floscha17/Bench/docs/vorentwurf-studio.pdf

STUDIOENTWURF / FITNESSMÖBEL

# Wohnbank mit Trainingsfunktion

Eiche · cognacfarbenes Leder · verschwindende Rollfront · verdeckte Mobilität

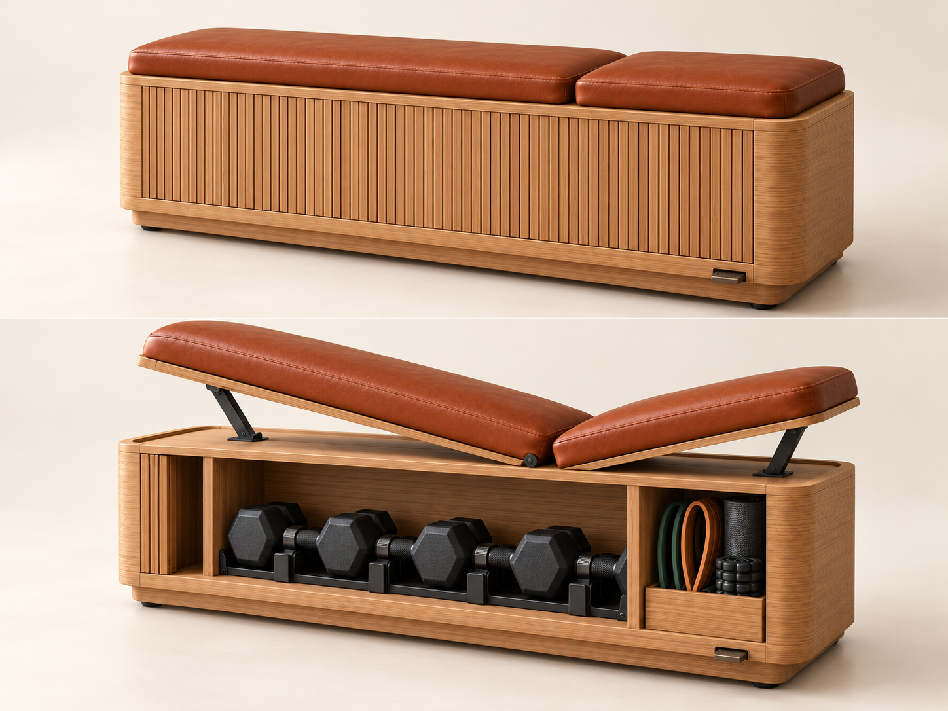
[picture p14: figure]

V01 · 24.10.2026 · Besprechungsgrundlage, keine Fertigungsfreigabe | 01 / 07

GESTALTUNGSZIEL

Ein hochwertiges Wohnmöbel, das sich mit wenigen Handgriffen in eine Schrägbank verwandelt.

### 01 ZWEI POLSTER

Lange Rückenlehne und kurzer Sitz separat anstellbar; geschlossen beide flach.

### 02 FREIE FRONT

Lamellen laufen nach links um die Ecke und im Korpus weiter nach hinten.

### 03 SICHER VERSTAUT

Hanteln einzeln in gepolsterten, verriegelbaren Aufnahmen.

### 04 BEWEGLICH

Vier Rollen gemeinsam ausfahren. Zum Training auf feste Füße absetzen.

Visualisierung der Gestaltung. Hantelzahl, Beschläge und Proportionen im Rendering sind nicht maßverbindlich. Verbindliche Abstimmung anhand der folgenden Maß- und Funktionsblätter.

# Abmessungen und Proportionen

Alle Maße in mm · Vorschlag zur Abstimmung · Zeichnungen 1:8 bei Ausdruck auf A4 mit 100 %

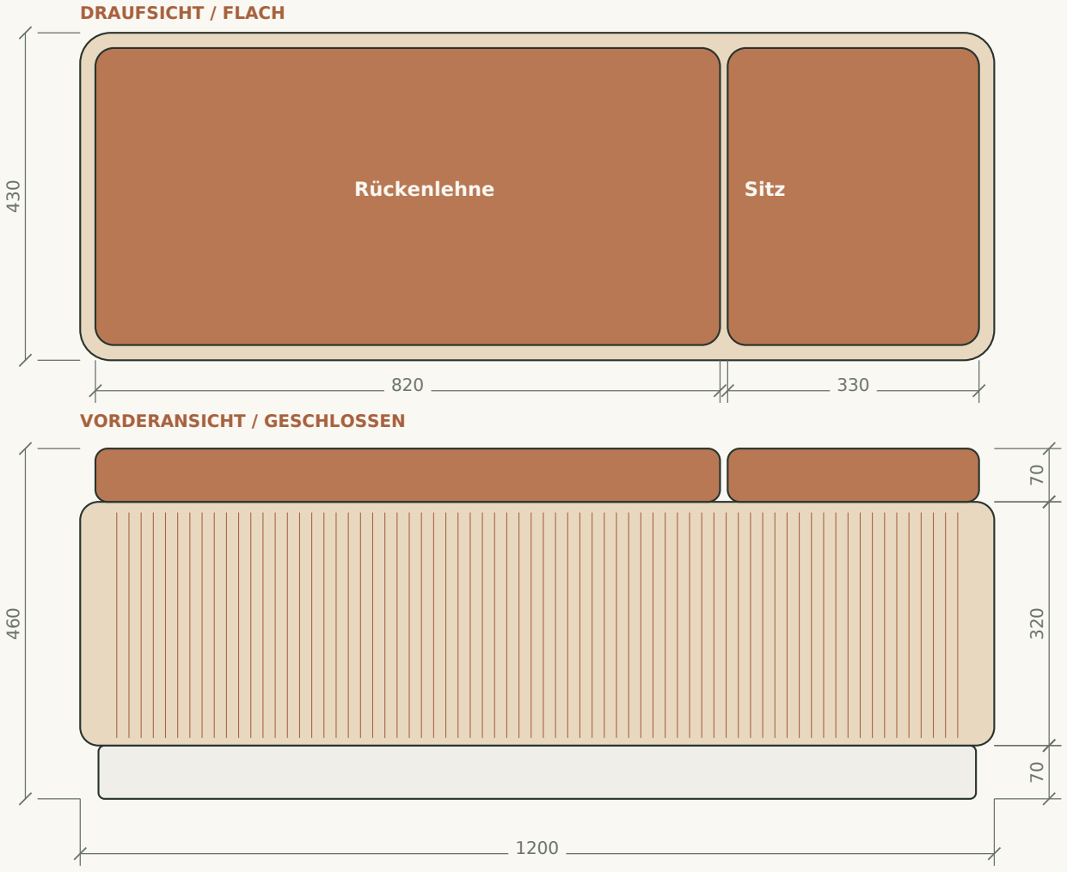
[picture p15: figure]
VORDERANSICHT / GESCHLOSSEN; DRAUFSICHT / FLACH; Rückenlehne; Sitz
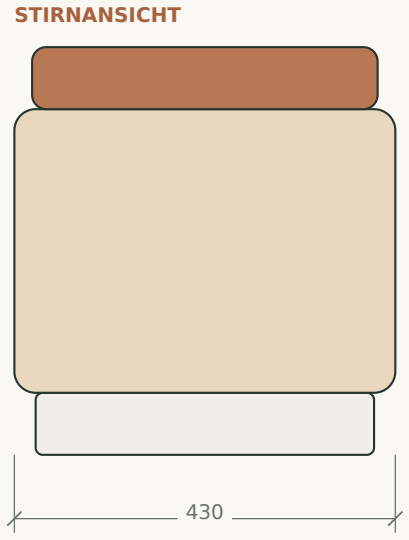
[picture p16: figure]
STIRNANSICHT

V01 · 24.10.2026 · Besprechungsgrundlage, keine Fertigungsfreigabe | 02 / 07

PLANUNGSWERTE

Außen: 1200 × 430 × 460
Polster: 820 + 10 Fuge + 330 Rand links/rechts: je 20
Polsterbreite: 390
Aufbau Polster + Träger: 70 Sockel inkl. Füße: 70

Maßkette Länge: 20 + 820 + 10 + 330 + 20 = 1200. Höhe: 70 Sockel + 320 Korpus + 70 Polsterpaket = 460. Sockelhöhe und Polsterbreite nach Beschlagwahl bzw. Liegeprobe ggf. anpassen.

# Zwei unabhängig verstellbare Polster

Funktionsskizze · Außenkontur 1:8 · Beschläge und Lastpfade sind schematisch

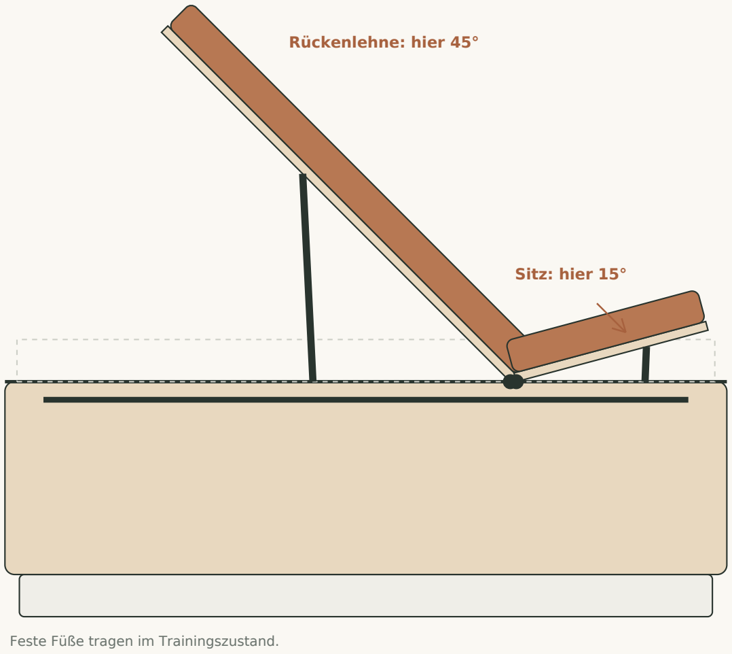
[picture p17: figure]
Rückenlehne: hier 45°; Sitz: hier 15°; Feste Füße tragen im Trainingszustand.

V01 · 24.10.2026 · Besprechungsgrundlage, keine Fertigungsfreigabe | 03 / 07

VERSTELLBEREICHE / ZIEL

Rückenlehne: 0 / 15 / 30 / 45 / 60°
Sitz: 0 / 10 / 15°

Rastpunkte sind Vorschläge. Ergonomie und verfügbare Beschläge entscheiden über die endgültigen Stellungen.

KONSTRUKTIVE VORGABE

Beide Träger an einem gemeinsamen inneren Metallrahmen lagern. Quer abgestützte, formschlüssig verriegelnde Beschläge verwenden; keine einfache Möbelklappenstütze als Lastaufnahme.

VOR FREIGABE PRÜFEN

Schulterfreiheit bei 390 mm Polsterbreite; Spalt am Gelenk; Fingerfreiheit; Verriegelung in jeder Stellung; dynamische Trainingslasten und Kippsicherheit.

Die Zeichnung legt keine Stahlquerschnitte, Bolzendurchmesser oder Traglast fest. Metallbauer / Beschlaglieferant müssen die Auslegung übernehmen.

# Rollfront: nach links um die Ecke

Draufsicht ohne Polster / Deckplatte · schematischer Laufweg · Außenkontur 1:5

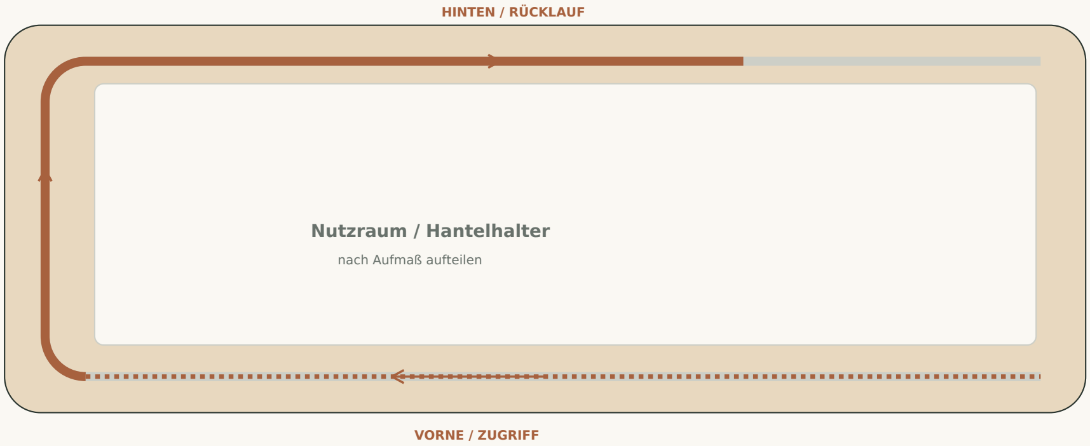
[picture p18: figure]
Nutzraum / Hantelhalter; nach Aufmaß aufteilen; VORNE / ZUGRIFF; HINTEN / RÜCKLAUF

V01 · 24.10.2026 · Besprechungsgrundlage, keine Fertigungsfreigabe | 04 / 07

LAMELLEN & FÜHRUNG

Schmale Eichenlamellen auf flexiblem Träger; oben und unten geführt. Laufweg gestrichelt = geschlossen, durchgezogen = zurückgeschoben.

BAURAUM RESERVIEREN

Linke Seite und Rückwand benötigen einen getrennten Rücklaufkanal. Innenraum deshalb nicht aus den Außenmaßen ableiten.

BESCHLAG BESTIMMT DETAILS

Kurvenradius, Lamellenbreite, Dicke, Fugen und Nuten nach einem geeigneten Rolladensystem festlegen. Schablone vor Fertigung testen.

# Hanteln einhängen und gegen Bewegung sichern

Prinzipdarstellung einer Einzelaufnahme · nicht maßstäblich · an die tatsächlichen Hanteln anpassen

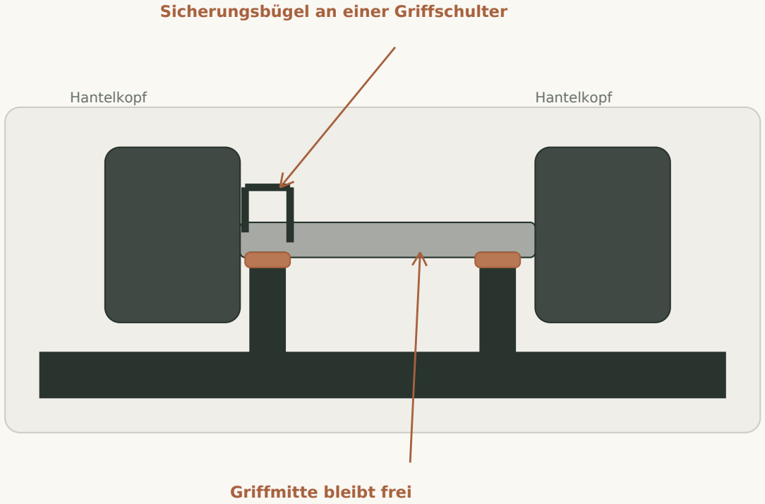
[picture p19: figure]
Sicherungsbügel an einer Griffschulter; Griffmitte bleibt frei; Hantelkopf

V01 · 24.10.2026 · Besprechungsgrundlage, keine Fertigungsfreigabe | 05 / 07

AUFNAHMEPRINZIP

Zwei gepolsterte Auflagen tragen die Hantel nahe den Köpfen. Seitliche Anschläge begrenzen das Verschieben; ein lösbarer Bügel verhindert Herausspringen.

BEDIENUNG

Bügel lösen, Hantel leicht anheben und entnehmen. Beim Einsetzen muss die Verriegelung eindeutig erkennbar schließen.

BEFESTIGUNG

Aufnahmen verschraubt an Metalltraversen; keine tragenden Haken nur in einer dünnen Holzrückwand. Polster austauschbar vorsehen.

Kapazität erst nach Aufmaß festlegen: Das frühere Rendering mit zwei vollen Hantelreihen ist keine bestätigte Innenaufteilung.

Benötigt: Anzahl, Gewicht, Gesamtlänge, Kopfdurchmesser, freie Grifflänge und Griffdurchmesser jeder Hantel. Schwere Gewichte möglichst tief anordnen.

# Verdecktes Fahrwerk mit gemeinsamer Betätigung

Zwei Betriebszustände · Funktionsschema ohne festgelegte Beschlaggeometrie

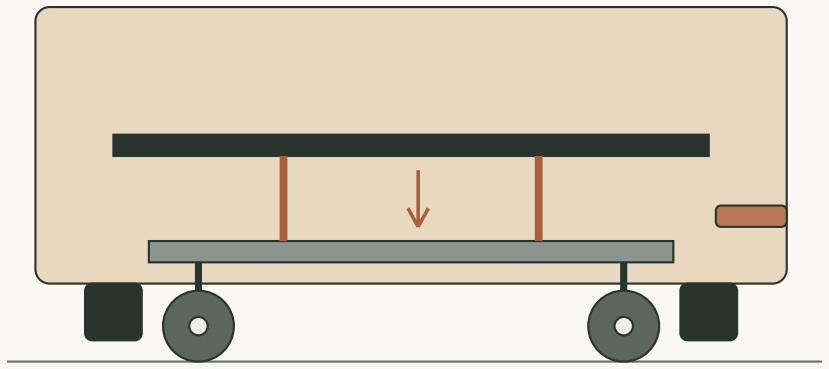
[picture p20: figure]
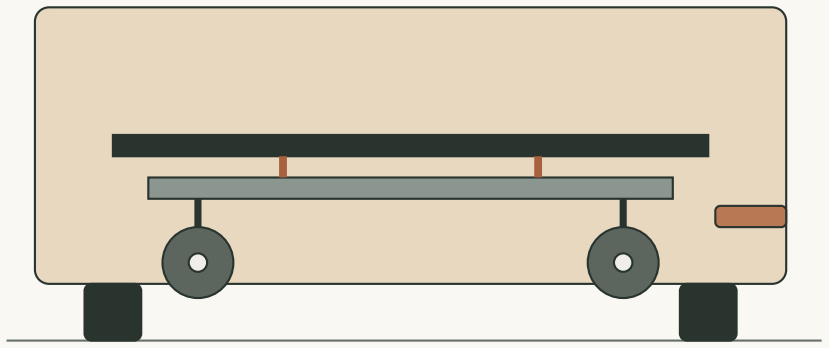
[picture p21: figure]

V01 · 24.10.2026 · Besprechungsgrundlage, keine Fertigungsfreigabe | 06 / 07

A ABGESTELLT / TRAINIEREN

Feste Füße tragen die gesamte Bank. Rollen haben Bodenfreiheit. Der Hubantrieb liegt außerhalb des Trainingslastpfades.

B ROLLEN / NUR TRANSPORT

Rollenrahmen abgesenkt, Füße leicht angehoben. Vier Lenkrollen ermöglichen Verschieben und seitliches Rangieren.

BEDIENUNG

Versenktes Fußpedal rechts im Sockel. Hebel und gekoppelte Wellen bewegen einen geführten Rahmen mit allen vier Rollen.

ZIELWERTE / OFFEN

Etwa 5-10 mm Fußfreiheit auf glattem Boden. Rollendurchmesser, Hub, Pedalkraft und Sockelhöhe anhand des Gesamtgewichts auslegen.

VERRIEGELUNG

Transportstellung sicher verriegeln, Absenken kontrollieren. Polster flach, Rollfront geschlossen; beim Verschieben keine Person auf der Bank.

# Briefing für Angebot und Werkstattplanung

Die Gestaltung ist definiert. Beschläge, Innenaufteilung und Tragstruktur folgen im nächsten Planungsschritt.

V01 · 24.10.2026 · Besprechungsgrundlage, keine Fertigungsfreigabe | 07 / 07

GEWÜNSCHTE AUSFÜHRUNG

Korpus | Eiche natur, matt; ruhige Maserung und gerundete Ecken. Formstabile Plattenkonstruktion mit Eichenoberfläche als Vorschlag.
Polster | Cognacfarbenes Leder, feste Trainingspolsterung; zwei getrennte Träger. Bezug und Polster austauschbar vorsehen.
Rollfront | Vertikale Eichenlamellen; vollständig nach links über die Seite in den rückwärtigen Kanal verschiebbar.
Tragstruktur | Innenliegender Metallrahmen für Lehne, Sitz, Hantelaufnahmen und feste Füße. Holzverkleidung separat behandeln.
Mobilität | Gemeinsamer Rollenrahmen mit vier Lenkrollen und verdecktem Fußpedal; gut zugängliche Wartungsöffnung.
Alternative | Elektrischer Taster mit Spindelantrieb optional separat anbieten; im vorliegenden Konzept nicht ausgearbeitet.

VOR DER FERTIGUNG KLÄREN

### 1 Nutzergröße, maximales Nutzergewicht und maximale

Trainingsgewichte festlegen.

### 2 Originalhanteln vermessen; Anzahl und Halter mit Papp- oder

Holzmodell im Innenraum prüfen.

3

Sitz- und Liegeprobe: Länge, Polsterbreite, Festigkeit und Verstellwinkel bestätigen.

### 4 Rolladensystem auswählen; Rücklauf, Nutzraum und

Wartungszugang gemeinsam planen.

5 Metallbau / Beschlaglieferant: Lasten, Verbindungen, Verriegelung und Kippsicherheit nachweisen.

6 Rollenmechanik mit voller Beladung testen; Bodenfreiheit, Pedalkraft und kontrolliertes Absenken prüfen.

Angebot bitte getrennt nach Holzbau, Polster, Metallbau/Beschlägen und Fahrwerk. Zuschnittliste erst nach Abschluss der Beschlagplanung.
Entwurfsbasis: gemeinsam entwickelte Gestaltung, inspiriert von der Technogym Bench. Bildansichten sind KI-generierte Konzeptvisualisierungen; Zeichnungen dienen der Abstimmung.
