floscha17/Bench/cad/params.scad

// AUTOMATISCH ERZEUGT von tools/build.py aus params.toml – nicht von Hand ändern.

L = 1200;
D = 430;
H = 450;
R = 70;
t = 19;
ti = 12;
polster_h = 70;
polster_z0 = 380;
rand_top = 380;
deckel_z0 = 336;
deckel_z1 = 355;
boden_z0 = 70;
boden_z1 = 89;
korpus_h = 310;
innen_l = 1162;
innen_h = 247;
pad_y0 = 31;
pad_b = 368;
pad_r_aussen = 39;
lehne_x0 = 22;
lehne_x1 = 832;
lehne_l = 810;
sitz_x0 = 848;
sitz_x1 = 1178;
rt_x0 = 70;
rt_x1 = 1130;
rt_len = 1060;
rt_y0 = 3;
rt_n = 54;
rt_b = 18.157;
rt_hinten_y0 = 394;
fach_y0 = 22;
fach_y1 = 391;
fach_tiefe = 369;
tasche_x0 = 19;
tasche_x1 = 119;
mw_x = [119, 791];
fach_x0 = [131, 803];
fach_breiten = [660, 378];
ebene_z0 = 217;
ebene_z1 = 229;
rohr_y0 = [22, 358];
stuetze_x = [133, 759, 1148];
stuetze_y = [47, 353];
fuss_pos = [[148, 62], [1163, 62], [148, 368], [1163, 368]];
rollen_pos = [[208, 117], [1103, 117], [208, 313], [1103, 313]];
pedal_x = 1050;
achse_z = 438;
vA = -64;
schiene_z = -77;
bein_y0 = [80, 325];
stab_y0 = 80;
stab_l = 270;
rippe_y0 = [130, 240];
achs_versatz = 8;
polster_platte = 18;
polster_r = 12;
rand = 25;
sockel_h = 70;
sockel_einzug = 25;
fuss_d = 40;
fuss_h = 10;
halter_luft = 12;
rt_fuge = 1.5;
rt_dicke = 14;
bein_b = 25;
bein_t = 8;
bolzen_d = 10;
schiene_h = 12;
schiene_b = 30;
rippe_b = 60;
rippe_h = 18;
gelenkplatte = 5;
konsole_b = 40;
rohr_b = 50;
rohr_h = 25;
stuetze_q = 30;
traverse_b = 30;
traverse_t = 8;
rolle_d = 50;
inhalt = [["khr", 173, 63.484, 89, 110, 112, 286.033, 100, 80.516], ["khr", 293, 63.484, 89, 110, 112, 286.033, 100, 80.516], ["khr", 413, 69.842, 89, 100, 102, 273.317, 90, 74.158], ["khr", 523, 69.842, 89, 100, 102, 273.317, 90, 74.158], ["khr", 633, 82.196, 89, 90, 92, 248.608, 80, 61.804], ["khr", 173, 82.196, 229, 90, 92, 248.608, 80, 61.804], ["box", 813, 96.5, 89, 160, 70, 220, 0, 0], ["khr", 273, 88.418, 229, 80, 82, 236.163, 70, 55.582], ["khr", 363, 88.418, 229, 80, 82, 236.163, 70, 55.582], ["khr", 453, 105.355, 229, 80, 82, 202.29, 70, 38.645], ["khr", 543, 105.355, 229, 80, 82, 202.29, 70, 38.645], ["box", 813, 36.5, 229, 300, 60, 340, 0, 0], ["box", 983, 81.5, 89, 160, 60, 250, 0, 0]];
abflachung = 4;
griff_d = 32;
lehne_achse_x = 840;
lehne_dir = -1;
lehne_laenge = 810;
lehne_s = 390;
lehne_l_stuetze = 390;
lehne_winkel_liste = [15, 30, 45, 60];
lehne_loecher = [765.587, 694.089, 560.888, 325.276];
lehne_anschlag = 779.783;
lehne_schiene_x0 = 32;
lehne_schiene_x1 = 792;
lehne_rippe_l = 430;
sitz_achse_x = 840;
sitz_dir = 1;
sitz_laenge = 330;
sitz_s = 230;
sitz_l_stuetze = 80;
sitz_winkel_liste = [10, 15];
sitz_loecher = [296.726, 267.338];
sitz_anschlag = 308.937;
sitz_schiene_x0 = 888;
sitz_schiene_x1 = 1168;
sitz_rippe_l = 0;
