floscha17/Bench/(commit log)

2026-10-24 Konzept, parametrisches Modell und Berechnung für Sitz-/Trainingsbank
    - params.toml als einzige Quelle für alle Maße
    - OpenSCAD-Modell mit Schiebetüren, Stauraum, Polster und Transportrollen
    - tools/build.py erzeugt Stückliste, Berechnung (Stauraum, Durchbiegung,
    Kippsicherheit) und Renderings
    - Konzept-Dokument: Machbarkeit, Zielkonflikte Möbel/Training, Material
    Claude-Session: https://claude.ai/code/session_01Q7XKyr6KEE1rLdyaxwMeqX
    [bank.scad, params.scad]
2026-10-24 Schrägbank-Mechanik und hochwertiges Design
    - Rückenlehne mit Drehachse knapp unter der Polsteroberfläche und
    Klappstütze: 0°, 25°, 35°, 45°, 60°, 75°, 85°
    - Rastpositionen, Stütz- und Achskräfte, Knicksicherheit werden aus
    params.toml berechnet und geprüft
    - Korpus aus Eiche massiv auf Gehrung, Lamellen-Schiebetüren,
    Lederpolster mit Schattenfuge, schwebender Sockel, verdeckte Rollen
    - Farbvarianten Eiche/Cognac und Nussbaum/Schwarz/Messing
    - Stückliste mit Stahlteilen, Konzept und README überarbeitet
    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
    [bank.scad, params.scad]
2026-10-24 Bettende, Schreiner-Unterlagen und selbstgebaute Hanteln
    - Länge 1400 mm für ein 180-cm-Bett, Sitz 400 / Lehne 945 mm
    - Schrägbank jetzt 20°–85°; build.py --stuetze-suchen findet die Stütze
    - 3 Fächer und 3 Lamellentüren, Deckelspannweite dadurch kürzer
    - Rollen verdeckt unter der Rückseite zum Abrücken vom Bett
    - Hanteln: Kopflängen aus Zielgewicht berechnet, passgenau verstaut
    - Maßskizzen als SVG (Übersicht, Querschnitt, Rastleiste, Metallteile, Hantel)
    - Schreiner-Unterlagen als Markdown und druckfertiges PDF
    - Konzept: Aufstellung am Bett, Lederwahl, Kosten mit Schreiner
    Claude-Session: https://claude.ai/code/sessi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
    [bank.scad, params.scad]
2026-10-24 Design nach Bildentwurf: Rundungen, Rolltür, Polsterwanne, neigbarer Sitz
    - Korpus mit Eckradius 70, Polster in einer 20 mm tiefen Wanne mit Eichenkante
    - Lamellen-Rolltür, die in eine Tasche links und hinter die Fächer läuft
    - Rückenlehne links (25°–85°), Sitz rechts neigbar (10°/20°) über zwei
    ineinander geschachtelte Klappbügel
    - Eichensockel mit schwarzen Füßen, verdeckte Absenkrollen mit Bronze-Fußhebel
    - Hanteln auf schwarzer Ablage, 3 Fächer mit je 2 Ebenen
    - Zeichnungen, Stückliste, Berechnung, Schreiner-Unterlagen und PDF aktualisiert
    - Bildentwurf als Referenz in docs/
    Claude-Session: https://claude.ai/cod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
    [bank.scad, params.scad]
2026-10-24 Studio-Vorentwurf V01 einarbeiten: 1200 mm, Stahlrahmen, verriegelnde Gleitstützen
    - Maße nach Vorentwurf: 1200 × 430 × 450, Lehne 0/15/30/45/60°, Sitz 0/10/15°
    - Innenliegender Stahlrahmen trägt Polster, Hanteln und Füße; Holz als furnierte Verkleidung
    - Gemeinsame Drehachse in der Fuge, Gleitstützen mit Indexbolzen in gelochten C-Schienen,
    Flachstellung über Endanschlag und Kugelschnäpper; Kantenabstand aller Stellungen geprüft
    - Hanteln einzeln in Aufnahmen auf Traversen, Packen weicht den Rahmenstützen aus
    - Rollenrahmen mit Exzenterwellen und Bronze-Pedal, Spindelantrieb als Option
    - Stückliste und Kosten nach vier Gewerken, Zeichnung der Gleitschienen statt Rastleiste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
    [bank.scad, params.scad]
